DoHongTha1/pptr_bilal_mubdir/docs/figures/misc/thrust_calibration.png

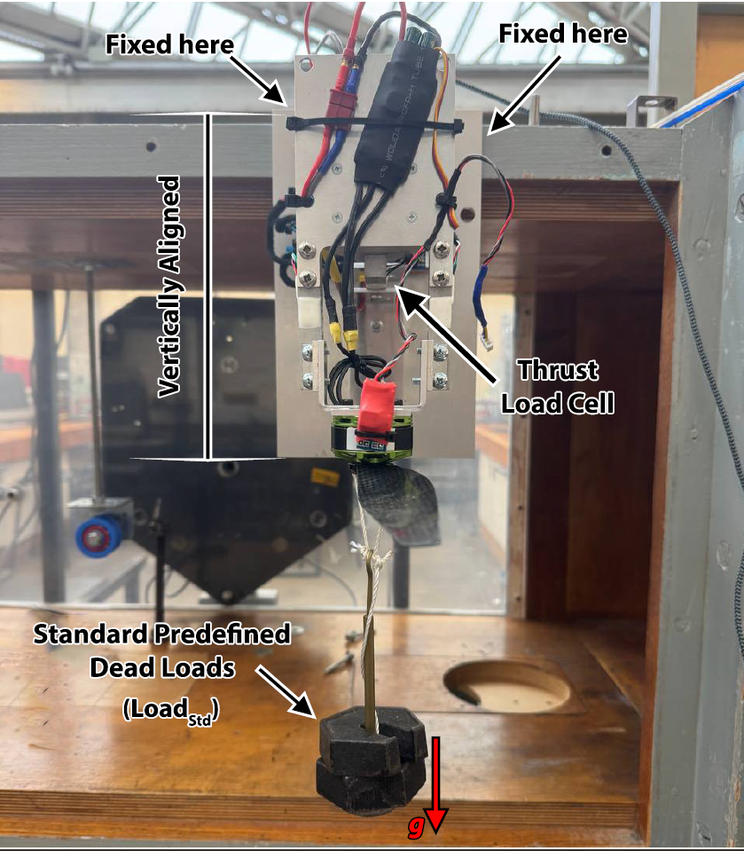
docs/figures/misc/thrust_calibration.png
