DoHongTha1/pptr_bilal_mubdir/docs/figures/misc/torque_calibration.png

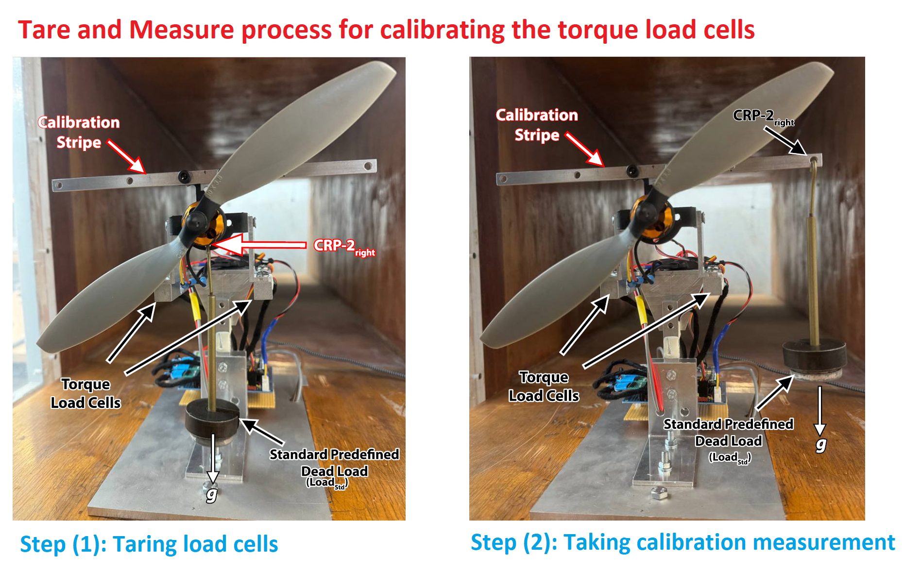
docs/figures/misc/torque_calibration.png
