DoHongTha1/pptr_bilal_mubdir/docs/tables/structure embedded sensors.tex

\begin{table}[H]
    \centering
    \footnotesize
    \caption{Summary of the sensors embedded in the PPTR Structure.}
    \begin{tabular}{>{\raggedright}p{1.2cm} >{\centering}p{0.8cm} >{\centering}p{1.7cm} >{\raggedright\arraybackslash}p{2.1cm}}
        \toprule
        \bf{Component}  & \bf{Quantity} & \bf{Function} & \bf{Specifications}\\
        \midrule
        Load cell & 1 & Thurst measurement & \thead[l]{Range: 0-\SI{1}{\kilogram},\\
                                               Voltage: 5-\SI{12}{\volt},\\
                                               Precision: $\mp$\SI{1}{\gram}}\\
        Load cell & 2 & Torque measurement & \thead[l]{Range: 0-\SI{1}{\kilogram},\\
                                               Voltage: 5-\SI{12}{\volt},\\
                                               Precision: $\mp$\SI{1}{\gram}}\\ 
        Infrared sensor & 1 & Rotational speed sensor & \thead[l]{Range: 1-\SI{38}{\kilo\hertz},\\
                                                               Voltage: 3-\SI{5}{\volt},\\
                                                               Detection angle: $35^{\circ}$}\\                             
        \bottomrule
    \end{tabular}
    \label{tab: ch3 PPTR sensors}
\end{table}
