DoHongTha1/pptr_bilal_mubdir/docs/figures/misc/pptr_cover2.png

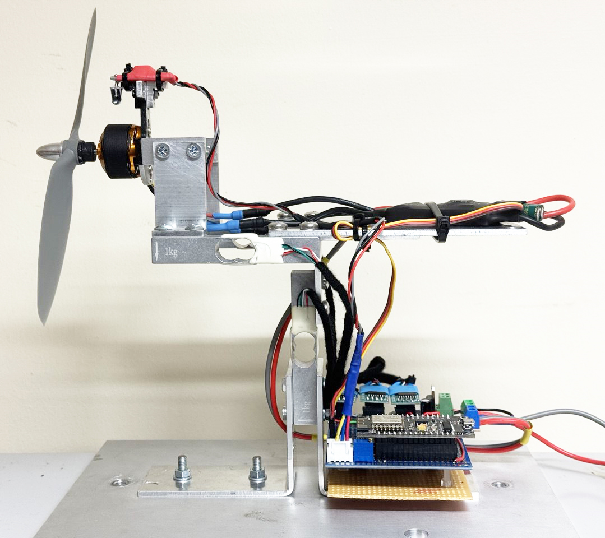
docs/figures/misc/pptr_cover2.png
