DoHongTha1/pptr_bilal_mubdir/docs/figures/misc/pptr_cover.png

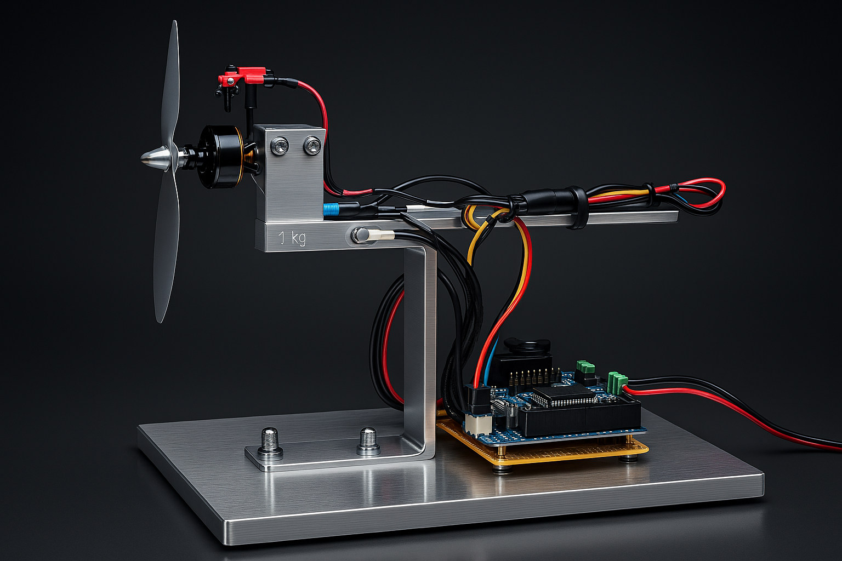
docs/figures/misc/pptr_cover.png
