DoHongTha1/pptr_bilal_mubdir/docs/figures/misc/pptr_structure_mutliviews.png

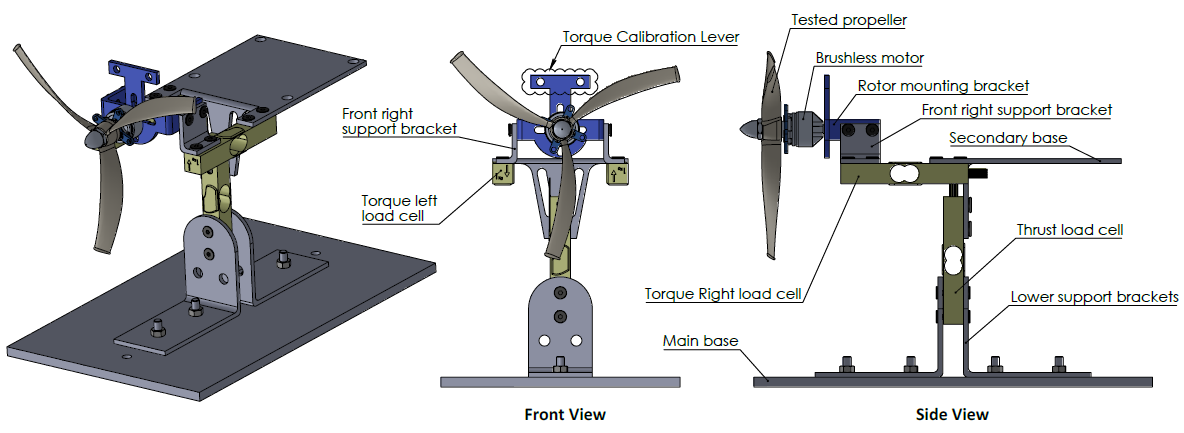
docs/figures/misc/pptr_structure_mutliviews.png
