DoHongTha1/pptr_bilal_mubdir/docs/figures/misc/pptr_system_diagram.png

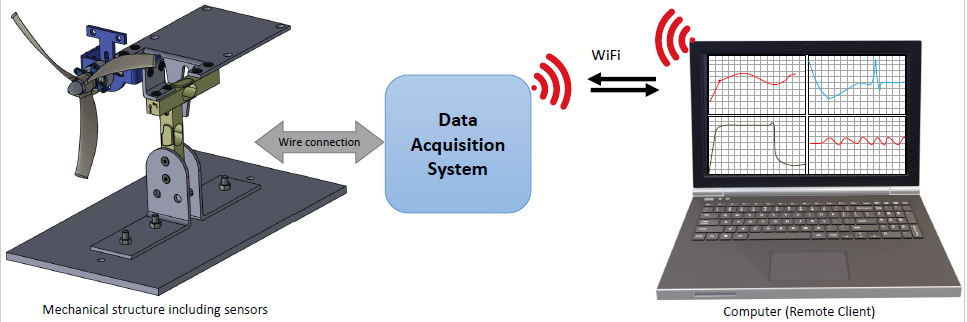
docs/figures/misc/pptr_system_diagram.png
