DoHongTha1/pptr_bilal_mubdir/docs/figures/mechanical/mech_bom.pdf

Part No. | Part Name | QTY
1 | | Main base | 1
2 | Lower support brackets | 2
3 | | Load cell | 3
4 | Secondary Base | 1
5 | Front | support brackets | 2
6 | Rotor mounting bracket | 1
