DoHongTha1/pptr_bilal_mubdir/docs/figures/mechanical/calibration_stripe.pdf

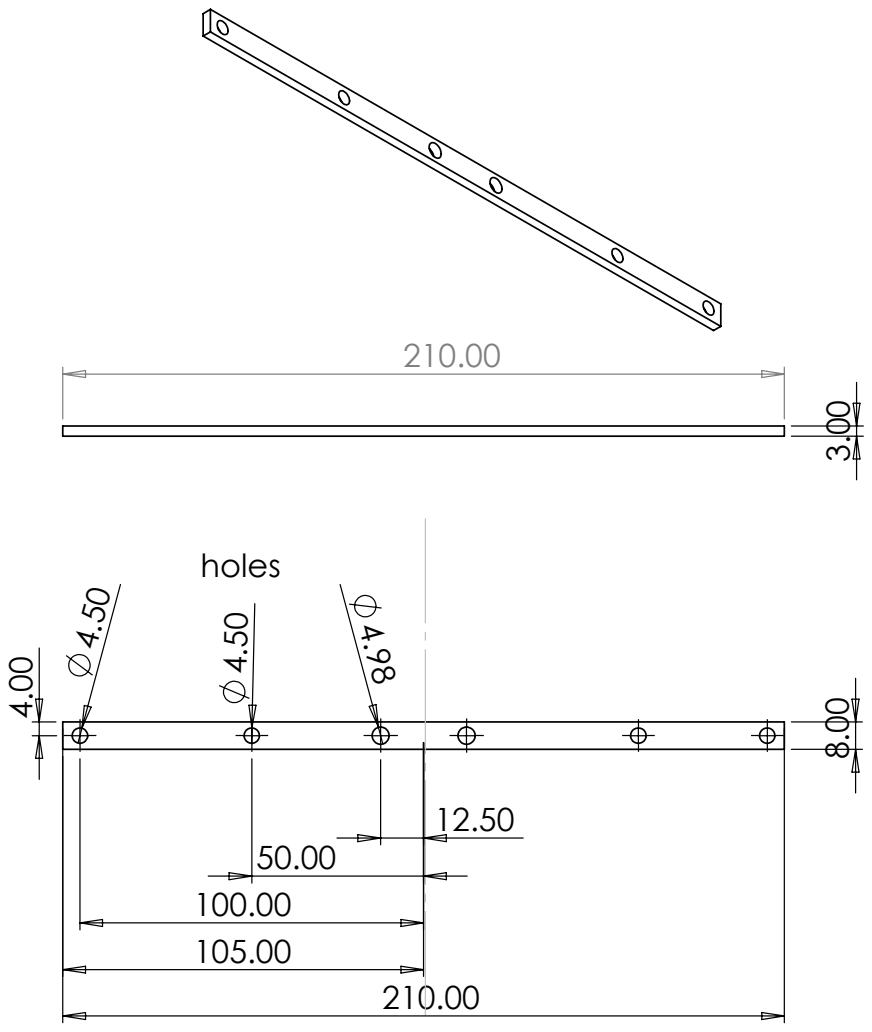
[picture p7: page 1]
