DoHongTha1/pptr_bilal_mubdir/docs/figures/mechanical/front_support_brackets.pdf

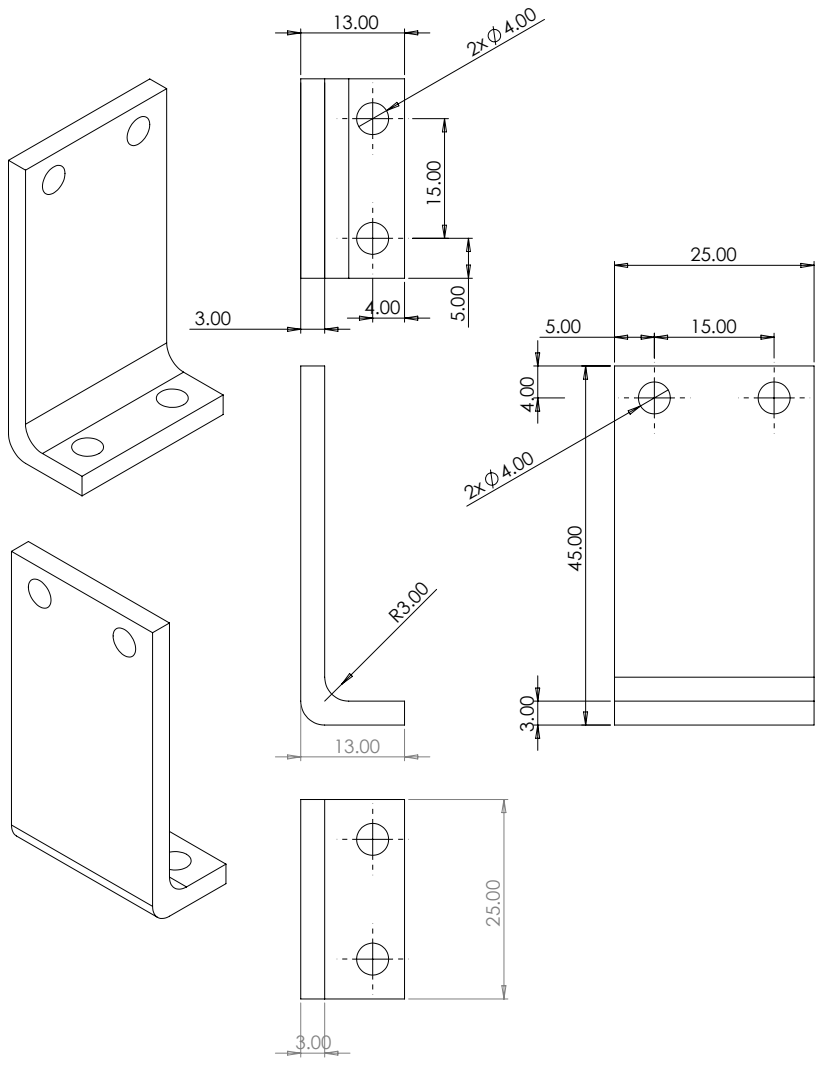
[picture p8: page 1]
