DoHongTha1/pptr_bilal_mubdir/docs/figures/mechanical/full_drawing.pdf

F | F

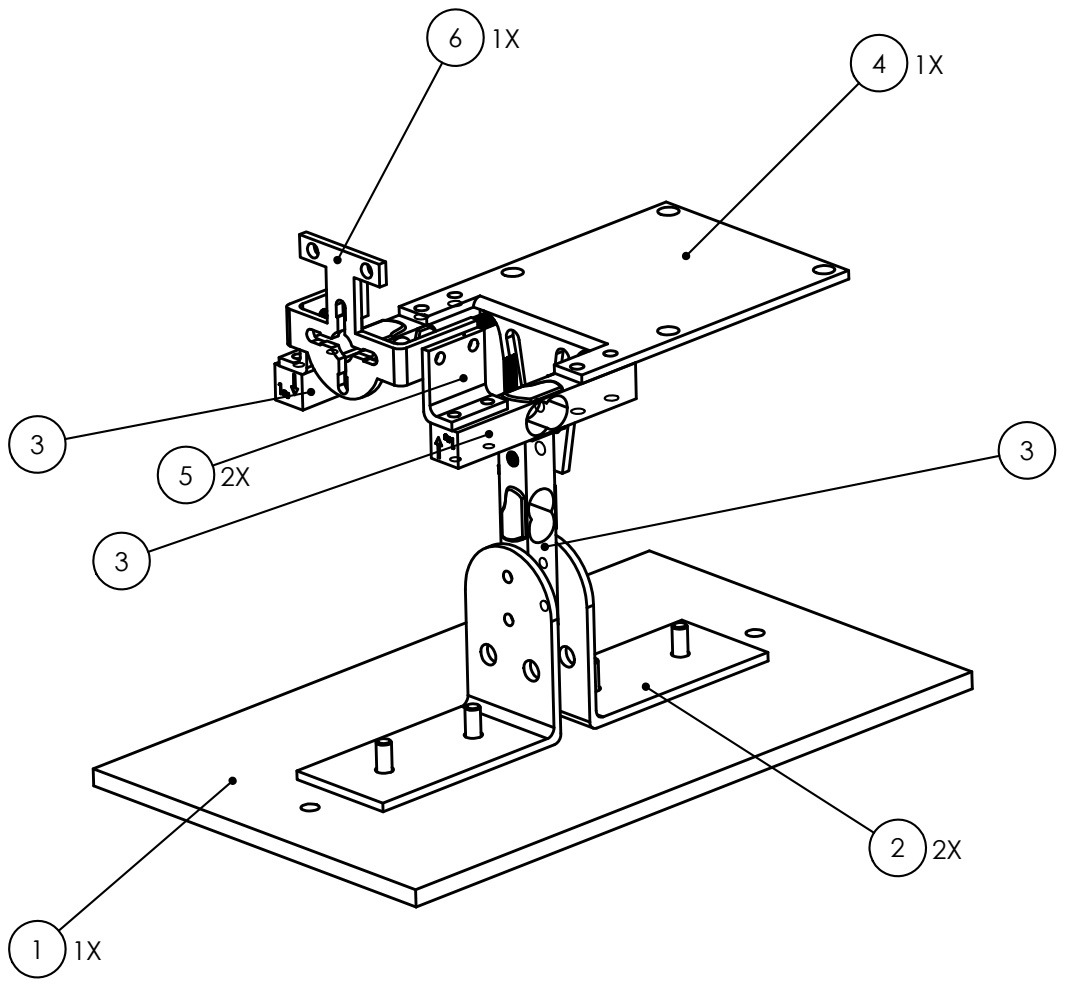
[picture p9: page 1]
