DoHongTha1/pptr_bilal_mubdir/docs/figures/mechanical/lower_support_brackets.pdf

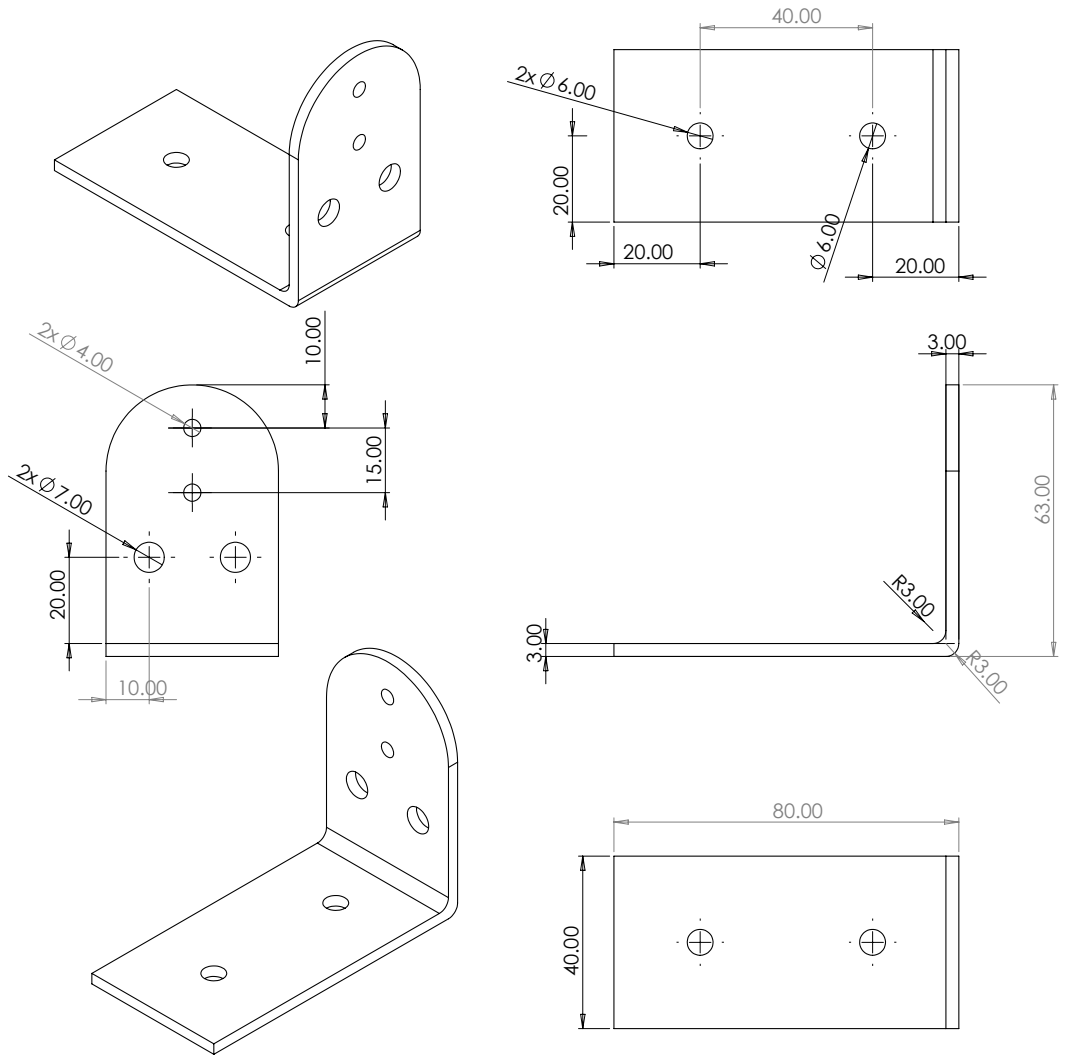
[picture p10: page 1]
