DoHongTha1/pptr_bilal_mubdir/docs/figures/mechanical/main_base.pdf

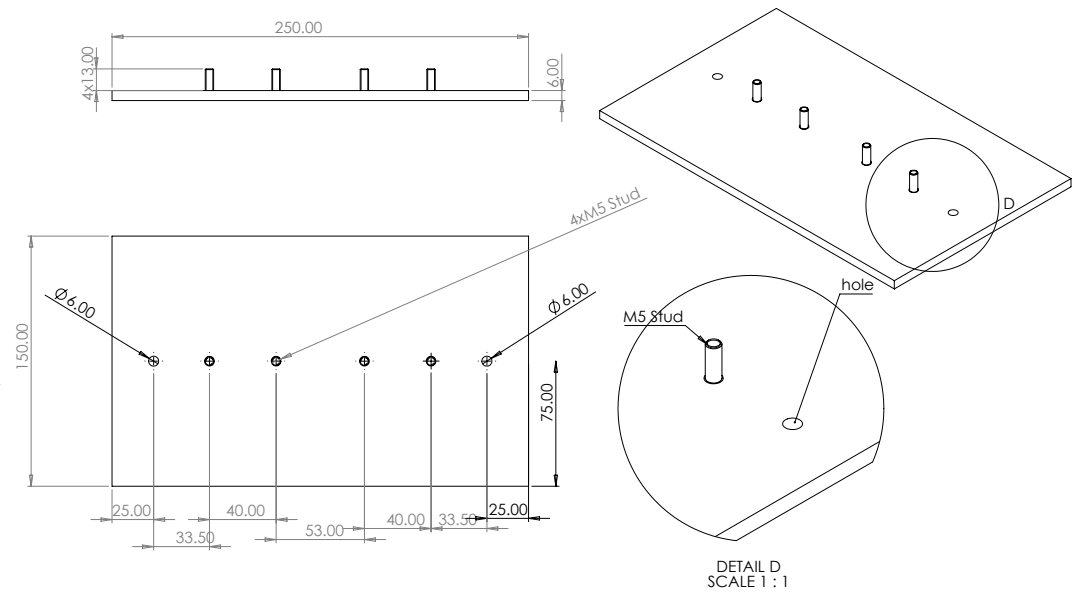
[picture p11: page 1]
4xM5 Stud; DETAIL D SCALE 1 : 1; M5 Stud
