DoHongTha1/pptr_bilal_mubdir/docs/figures/mechanical/rotor_mounting_bracket.pdf

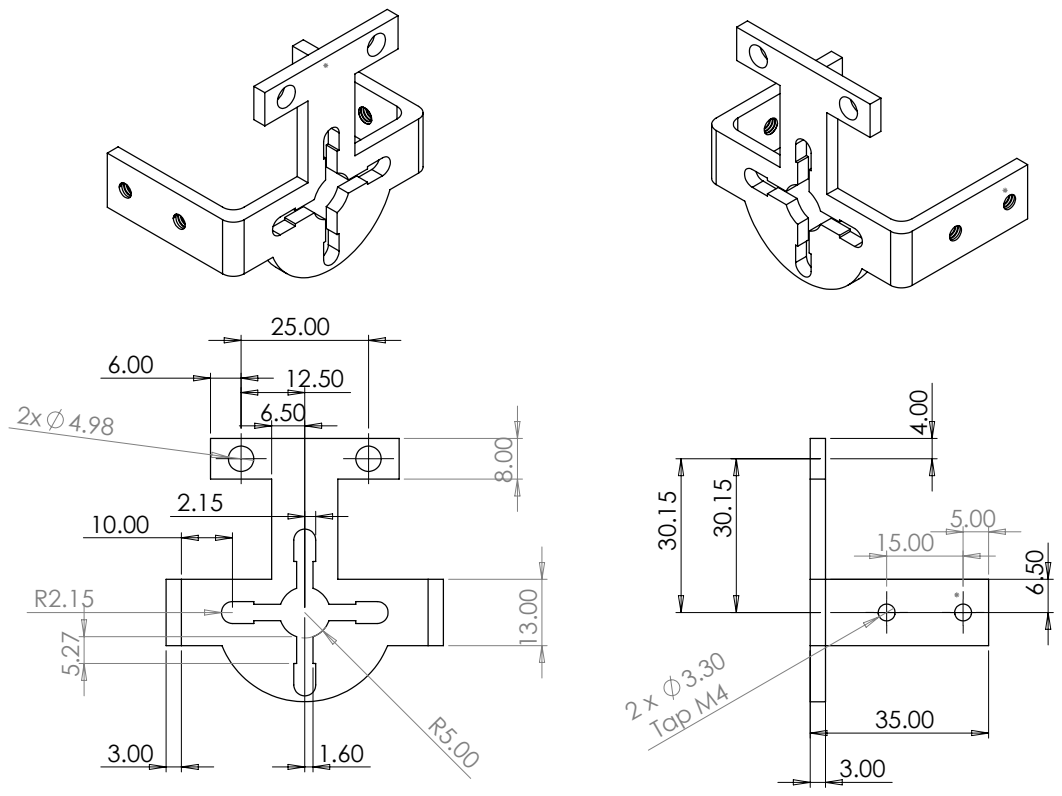
[picture p12: page 1]
Tap M4
