DoHongTha1/pptr_bilal_mubdir/docs/figures/mechanical/secondary_base.pdf

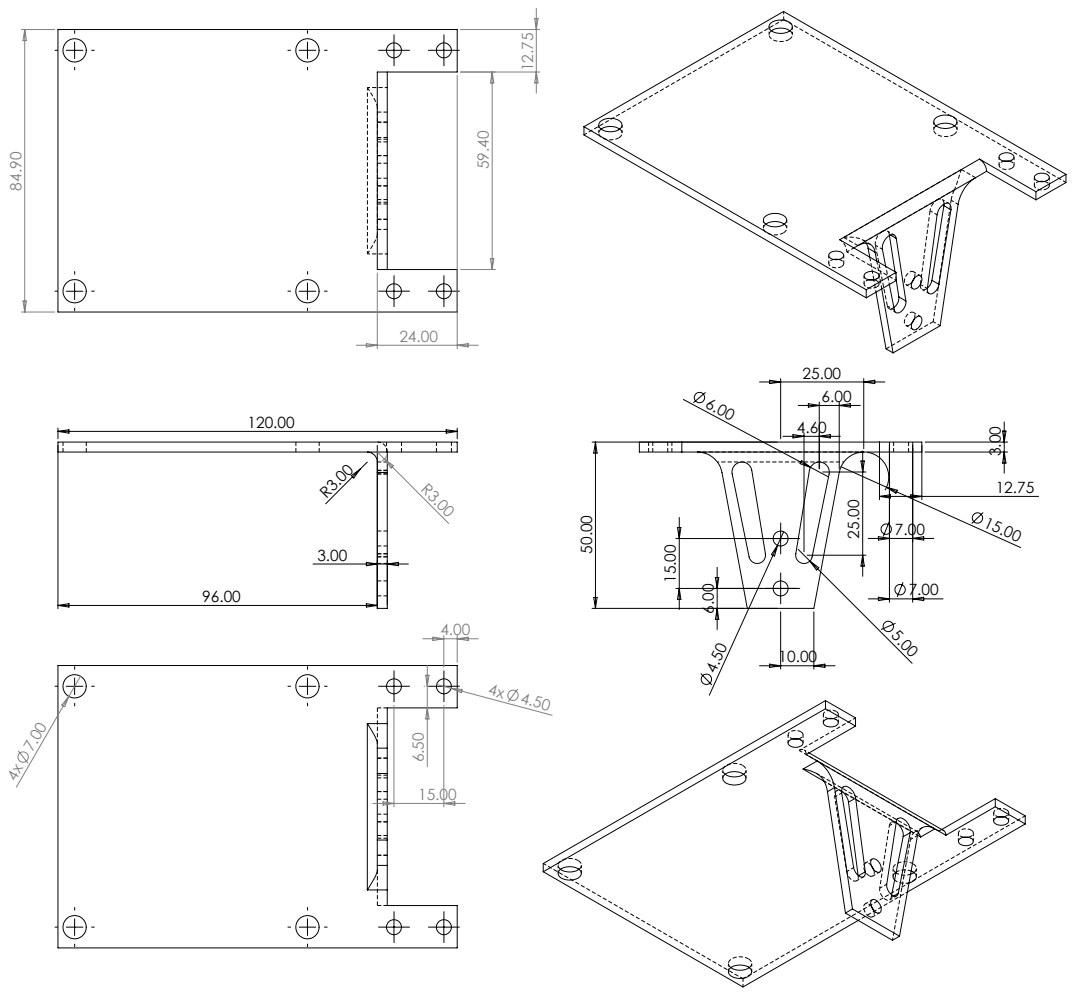
[picture p13: page 1]
