DoHongTha1/pptr_bilal_mubdir/docs/figures/electrical/DAQ_cct.pdf

## ESC312

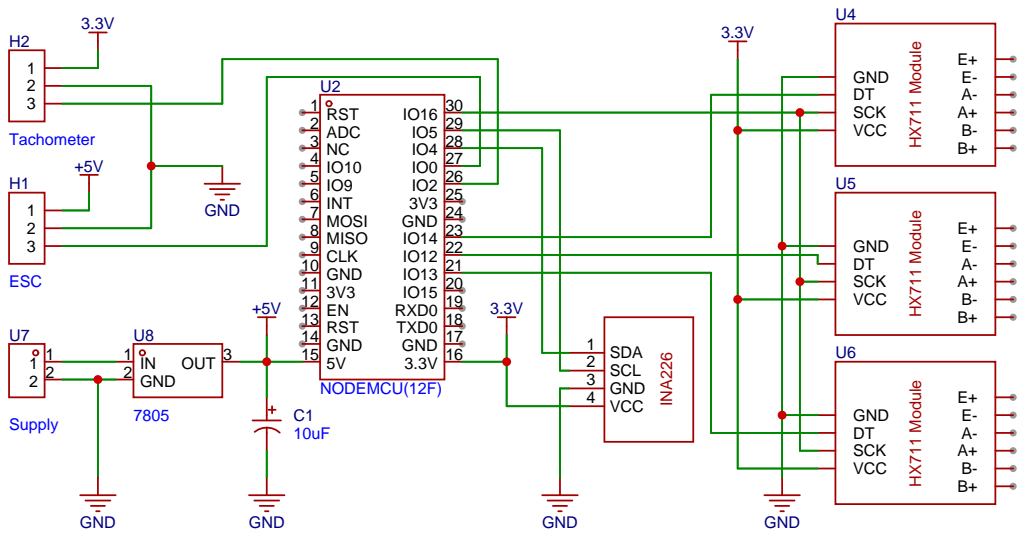
[picture p14: page 1]
