DoHongTha1/pptr_bilal_mubdir/docs/figures/electrical/HX711_cct.pdf

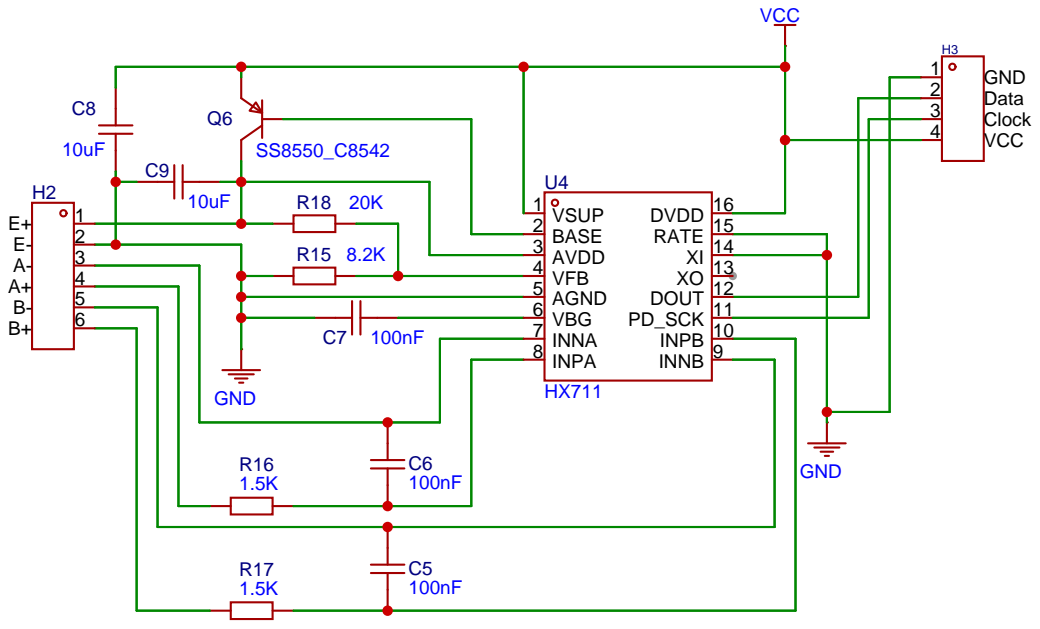
[picture p15: page 1]

INPB 10 PD_SCK 11 DOUT 12 XO 13 XI 14 RATE 15 DVDD 16
