DoHongTha1/pptr_bilal_mubdir/docs/figures/electrical/ina226_cct.pdf

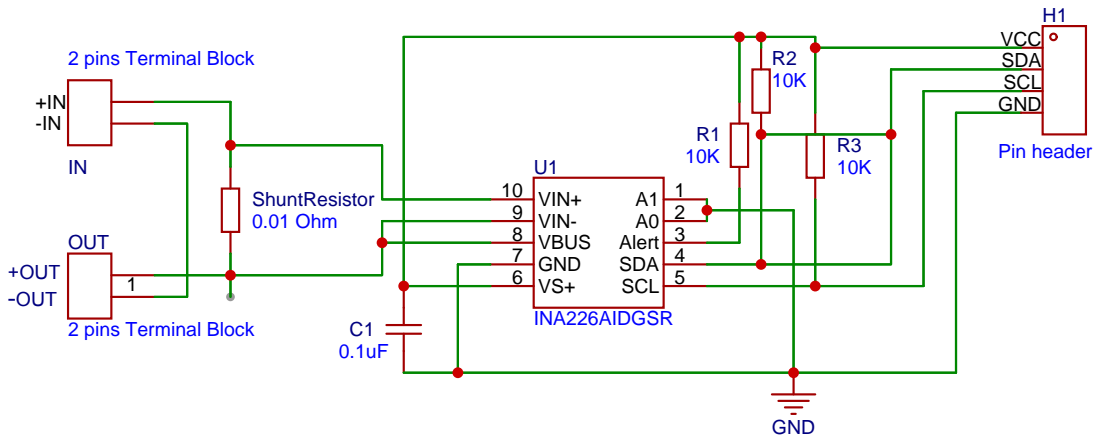
[picture p16: page 1]
