DoHongTha1/pptr_bilal_mubdir/docs/figures/electrical/tachometer_cct.pdf

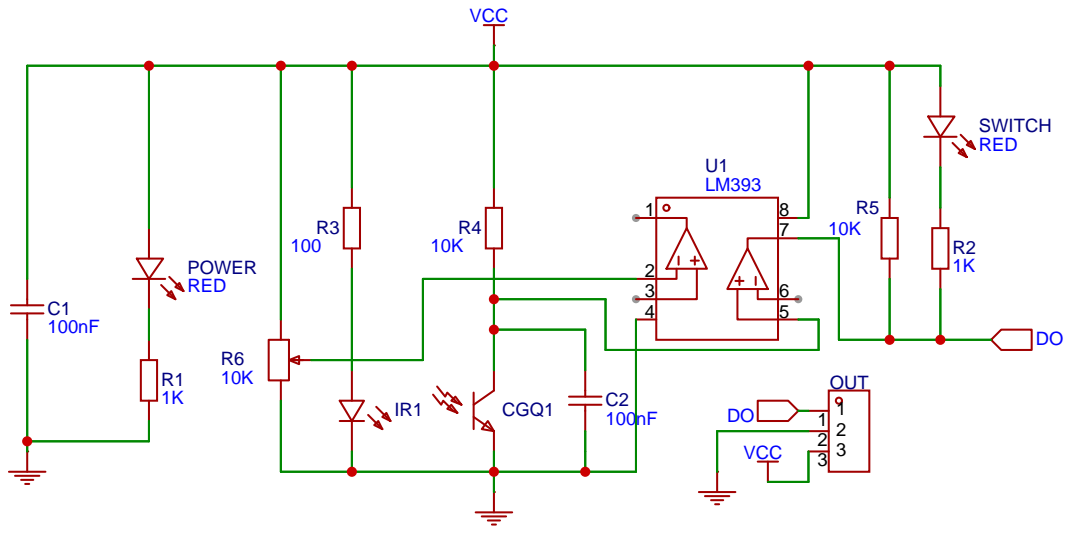
[picture p17: page 1]
